KK153402/NESTang-LCD-Primer25K/src/nestang_top.sv

//
// NESTang top level
// nand2mario
//

// `timescale 1ns / 100ps

import configPackage::*;

module nestang_top (
    input sys_clk,

    // Button S1 and pin 48 are both resets
    input s1,
    input reset2,

    // UART
    input UART_RXD,
    output UART_TXD,

    // LEDs
    output [1:0] led,

    // SDRAM - Tang SDRAM pmod 1.2 for primer 25k, on-chip 32-bit 8MB SDRAM for nano 20k
    output O_sdram_clk,
    output O_sdram_cke,
    output O_sdram_cs_n,            // chip select
    output O_sdram_cas_n,           // columns address select
    output O_sdram_ras_n,           // row address select
    output O_sdram_wen_n,           // write enable
    inout [SDRAM_DATA_WIDTH-1:0] IO_sdram_dq,      // bidirectional data bus
    output [SDRAM_ROW_WIDTH-1:0] O_sdram_addr,     // multiplexed address bus
    output [1:0] O_sdram_ba,        // two banks
    output [SDRAM_DATA_WIDTH/8-1:0] O_sdram_dqm,    

    // MicroSD
    output sd_clk,
    inout  sd_cmd,      // MOSI
    input  sd_dat0,     // MISO
    output sd_dat1,     // 1
    output sd_dat2,     // 1
    output sd_dat3,     // 1

    // SPI flash
    output flash_spi_cs_n,          // chip select
    input flash_spi_miso,           // master in slave out
    output flash_spi_mosi,          // mster out slave in
    output flash_spi_clk,           // spi clock
    output flash_spi_wp_n,          // write protect
    output flash_spi_hold_n,        // hold operations

`ifdef CONTROLLER_SNES
    // snes controllers
    output joy1_strb,
    output joy1_clk,
    input joy1_data,
    output joy2_strb,
    output joy2_clk,
    input joy2_data,
`endif

`ifdef CONTROLLER_DS2
    // dualshock controllers
    output ds_clk,
    input ds_miso,
    output ds_mosi,
    output ds_cs,
    // 2P (ds_clk2/ds_miso2/ds_mosi2/ds_cs2) は LCD 制御に転用したため削除 [LCD]
`endif

    // USB
//     inout usbdm,
//     inout usbdp,
// `ifndef PRIMER
//     inout usbdm2,
//     inout usbdp2,
// `endif

    // HDMI TX -> ILI9341 8080 8bit LCD [LCD]
    output       lcd_rst_n,
    output       lcd_cs_n,
    output       lcd_rs,
    output       lcd_wr_n,
    output [7:0] lcd_d
    // lcd_rd_n は FPGA から出さない (LCD 側で 3.3 V に固定)
);

// Core settings
wire arm_reset = 0;
wire [1:0] system_type = 2'b0;
wire pal_video = 0;
wire [1:0] scanlines = 2'b0;
wire joy_swap = 0;
wire mirroring_osd = 0;
wire overscan_osd = 0;
wire famicon_kbd = 0;
wire [3:0] palette_osd = 0;
wire [2:0] diskside_osd = 0;
wire blend = 0;
wire bk_save = 0;

// NES signals
reg reset_nes = 1;
reg clkref;
wire [5:0] color;
wire [15:0] sample;
wire [8:0] scanline;
wire [8:0] cycle;
wire [2:0] joypad_out;
wire joypad_strobe = joypad_out[0];
wire [1:0] joypad_clock;
wire [4:0] joypad1_data, joypad2_data;

wire sdram_busy;
wire [21:0] memory_addr_cpu, memory_addr_ppu;
wire memory_read_cpu, memory_read_ppu;
wire memory_write_cpu, memory_write_ppu;
wire [7:0] memory_din_cpu, memory_din_ppu;
wire [7:0] memory_dout_cpu, memory_dout_ppu;

reg [7:0] joypad_bits, joypad_bits2;
reg [1:0] last_joypad_clock;
wire [31:0] dbgadr;
wire [1:0] dbgctr;

wire [1:0] nes_ce;

wire loading;                 // from iosys or game_data
wire [7:0] loader_do;
wire loader_do_valid;

// iosys softcore
wire        rv_valid;
reg         rv_ready;
wire [22:0] rv_addr;
wire [31:0] rv_wdata;
wire [3:0]  rv_wstrb;
reg  [15:0] rv_dout0;
wire [31:0] rv_rdata = {rv_dout, rv_dout0};
reg         rv_valid_r;
reg         rv_word;           // which word
reg         rv_req;
wire        rv_req_ack;
wire [15:0] rv_dout;
reg [1:0]   rv_ds;
reg         rv_new_req;

// Controller
wire [7:0] joy_rx[0:1], joy_rx2[0:1];     // 6 RX bytes for all button/axis state
wire [7:0] usb_btn, usb_btn2;
wire usb_btn_x, usb_btn_y, usb_btn_x2, usb_btn_y2;
wire usb_conerr, usb_conerr2;
wire auto_a, auto_b, auto_a2, auto_b2;

// OR together when both SNES and DS2 controllers are connected (right now only nano20k supports both simultaneously)
wor [11:0] joy1_btns, joy2_btns;    // SNES layout (R L X A RT LT DN UP START SELECT Y B)
                                    // Lower 8 bits are NES buttons

// NES gamepad
wire [7:0]NES_gamepad_button_state;
wire NES_gamepad_data_available;
wire [7:0]NES_gamepad_button_state2;
wire NES_gamepad_data_available2;

// Loader
wire [21:0] loader_addr;
wire [7:0] loader_write_data;
reg loading_r;
always @(posedge clk) loading_r <= loading;
wire loader_reset = loading & ~loading_r;
wire loader_write;
wire [63:0] loader_flags;
reg  [63:0] mapper_flags;
wire loader_done, loader_fail;
wire loader_busy, loaded;
wire type_nes = 1'b1;  // (menu_index == 0) || (menu_index == {2'd0, 6'h1});
wire type_bios = 1'b0; // (menu_index == 2);
wire is_bios = 0;      //type_bios;
wire type_fds = 1'b0;  // (menu_index == {2'd1, 6'h1});
wire type_nsf = 1'b0;  // (menu_index == {2'd2, 6'h1});

wire int_audio;         // for VCR6
wire ext_audio;

///////////////////////////
// Clocks
///////////////////////////

wire clk;       // 21.477Mhz main clock
wire fclk;      // 3x clk SDRAM clock
wire hclk;      // 720p pixel clock: 74.25 Mhz
wire hclk5;     // 5x pixel clock: 371.25 Mhz
wire clk27;     // 27Mhz to generate hclk/hclk5
wire clk_usb;   // 12Mhz USB clock

reg sys_resetn = 0;
reg [7:0] reset_cnt = 255;      // reset for 255 cycles before start everything
always @(posedge clk) begin
    reset_cnt <= reset_cnt == 0 ? 0 : reset_cnt - 1;
    if (reset_cnt == 0)
//    if (reset_cnt == 0 && s1)     // for nano
        sys_resetn <= ~(joy1_btns[5] && joy1_btns[2]);    // 8BitDo Home button = Select + Down
end

`ifndef VERILATOR

`ifdef PRIMER
// sysclk 50Mhz
gowin_pll_27 pll_27 (.clkin(sys_clk), .clkout0(clk27));      // Primer25K: PLL to generate 27Mhz from 50Mhz
gowin_pll_nes pll_nes (.clkin(sys_clk), .clkout0(clk), .clkout1(fclk), .clkout2(O_sdram_clk));
`else
// sys_clk 27Mhz
assign clk27 = sys_clk;       // Nano20K: native 27Mhz system clock
gowin_pll_nes pll_nes(.clkin(sys_clk), .clkoutd3(clk), .clkout(fclk), .clkoutp(O_sdram_clk));
`endif  // PRIMER

gowin_pll_hdmi pll_hdmi (
    .clkin(clk27),
    .clkout(hclk5)
);

CLKDIV #(.DIV_MODE(5)) div5 (
    .CLKOUT(hclk),
    .HCLKIN(hclk5),
    .RESETN(sys_resetn),
    .CALIB(1'b0)
);

`else   // verilator

// dummy clocks for verilator
assign clk = sys_clk;
assign fclk = sys_clk;

`endif  // verilator

wire [31:0] status;


// Main NES machine
NES nes(
    .clk(clk), .reset_nes(reset_nes), .cold_reset(1'b0),
    .sys_type(system_type), .nes_div(nes_ce),
    .mapper_flags(mapper_flags),
    .sample(sample), .color(color),
    .joypad_out(joypad_out), .joypad_clock(joypad_clock), 
    .joypad1_data(joypad1_data), .joypad2_data(joypad2_data),

    .fds_busy(), .fds_eject(), .diskside_req(), .diskside(),        // disk system
    .audio_channels(5'b11111),  // enable all channels
    
    .cpumem_addr(memory_addr_cpu),
    .cpumem_read(memory_read_cpu),
    .cpumem_din(memory_din_cpu),
    .cpumem_write(memory_write_cpu),
    .cpumem_dout(memory_dout_cpu),
    .ppumem_addr(memory_addr_ppu),
    .ppumem_read(memory_read_ppu),
    .ppumem_write(memory_write_ppu),
    .ppumem_din(memory_din_ppu),
    .ppumem_dout(memory_dout_ppu),

    .bram_addr(), .bram_din(), .bram_dout(), .bram_write(), .bram_override(),

    .cycle(cycle), .scanline(scanline),
    .int_audio(int_audio),    // VRC6
    .ext_audio(ext_audio),

    .apu_ce(), .gg(), .gg_code(), .gg_avail(), .gg_reset(), .emphasis(), .save_written()
);

// loader_write -> clock when data available
reg loader_write_mem;
reg [7:0] loader_write_data_mem;
reg [21:0] loader_addr_mem;
reg loader_write_r;

always @(posedge clk) begin
    loader_write_mem <= 0;
    loader_write_r <= loader_write;

    loader_write_mem <= loader_write || loader_write_r;   // width 2
	if (loader_write) begin
		loader_addr_mem <= loader_addr;
		loader_write_data_mem <= loader_write_data;
	end

    if (loader_done)
        mapper_flags <= loader_flags;
end

// From sdram_nes.v or sdram_sim.v
sdram_nes sdram (
    .clk(fclk), .clkref(clkref), .resetn(sys_resetn), .busy(sdram_busy),

    .SDRAM_DQ(IO_sdram_dq), .SDRAM_A(O_sdram_addr), .SDRAM_BA(O_sdram_ba), 
    .SDRAM_nCS(O_sdram_cs_n), .SDRAM_nWE(O_sdram_wen_n), .SDRAM_nRAS(O_sdram_ras_n), 
    .SDRAM_nCAS(O_sdram_cas_n), .SDRAM_CKE(O_sdram_cke), .SDRAM_DQM(O_sdram_dqm), 

    // PPU
    .addrA(memory_addr_ppu), .weA(memory_write_ppu), .dinA(memory_dout_ppu),
    .oeA(memory_read_ppu), .doutA(memory_din_ppu),

    // CPU
    .addrB(loading ? loader_addr_mem : memory_addr_cpu), .weB(loader_write_mem || memory_write_cpu),
    .dinB(loading ? loader_write_data_mem : memory_dout_cpu),
    .oeB(~loading & memory_read_cpu), .doutB(memory_din_cpu),

    // IOSys risc-v softcore
    .rv_addr({rv_addr[20:2], rv_word}), .rv_din(rv_word ? rv_wdata[31:16] : rv_wdata[15:0]), 
    .rv_ds(rv_ds), .rv_dout(rv_dout), .rv_req(rv_req), .rv_req_ack(rv_req_ack), .rv_we(rv_wstrb != 0)
);

// ROM parser
GameLoader loader(
    .clk(clk), .reset(~sys_resetn | loader_reset), .downloading(loading), 
    .filetype({4'b0000, type_nsf, type_fds, type_nes, type_bios}),
    .is_bios(is_bios), .invert_mirroring(1'b0),
    .indata(loader_do), .indata_clk(loader_do_valid),

    .mem_addr(loader_addr), .mem_data(loader_write_data), .mem_write(loader_write),
    .bios_download(),
    .mapper_flags(loader_flags), .busy(loader_busy), .done(loader_done),
    .error(loader_fail), .rom_loaded()
);

assign int_audio = 1;
assign ext_audio = (mapper_flags[7:0] == 19) | (mapper_flags[7:0] == 24) | (mapper_flags[7:0] == 26);

always @(posedge clk) begin
    clkref <= ~clkref;
    if (~loading && loading_r) begin
        reset_nes <= 0;
        clkref <= 1;
    end else if (loading && ~loading_r)
        reset_nes <= 1;
    if (~sys_resetn)
        reset_nes <= 1;
end

///////////////////////////
// Peripherals
///////////////////////////

`ifdef VERILATOR

// For verilator, the only peripheral is the compiled-in game data 
GameData game_data(
    .clk(clk), .reset(~sys_resetn), .downloading(loading), 
    .odata(loader_do), .odata_clk(loader_do_valid));

`else

// For physical board, there's HDMI, iosys, joypads, and USB
wire overlay;                   // iosys controls overlay
wire [10:0] overlay_x;
wire [9:0]  overlay_y;
wire [15:0] overlay_color;      // BGR5

// HDMI output -> LCD に置き換え [LCD]
assign overlay_x = 11'd0;   // nes2hdmi が駆動していた iosys(textdisp) の入力を固定
assign overlay_y = 10'd0;
wire lcd_init_done;

nes2lcd u_lcd (
    .clk(clk), .resetn(sys_resetn),
    .color(color), .cycle(cycle), .scanline(scanline),
    .lcd_rst_n(lcd_rst_n), .lcd_cs_n(lcd_cs_n), .lcd_rs(lcd_rs),
    .lcd_wr_n(lcd_wr_n), .lcd_rd_n(), .lcd_d(lcd_d),
    .init_done(lcd_init_done), .frame_start()
);

/*
nes2hdmi u_hdmi (     // purple: RGB=440064 (010001000_00000000_01100100), BGR5=01100_00000_01000
    .clk(clk), .resetn(sys_resetn),
    .color(color), .cycle(cycle), 
    .scanline(scanline), .sample(sample >> 1),
    .overlay(overlay), .overlay_x(overlay_x), .overlay_y(overlay_y),
    .overlay_color(overlay_color),
    .clk_pixel(hclk), .clk_5x_pixel(hclk5),
    .tmds_clk_n(tmds_clk_n), .tmds_clk_p(tmds_clk_p),
    .tmds_d_n(tmds_d_n), .tmds_d_p(tmds_d_p)
);
*/

// IOSys for menu, rom loading...
localparam RV_IDLE_REQ0 = 3'd0;
localparam RV_WAIT0_REQ1 = 3'd1;
localparam RV_DATA0 = 3'd2;
localparam RV_WAIT1 = 3'd3;
localparam RV_DATA1 = 3'd4;
reg [2:0]   rvst;

always @(posedge clk) begin            // RV
    if (~sys_resetn) begin
        rvst <= RV_IDLE_REQ0;
        rv_ready <= 0;
    end else begin
        reg write = rv_wstrb != 0;
        reg rv_new_req_t = rv_valid & ~rv_valid_r;
        if (rv_new_req_t) rv_new_req <= 1;

        rv_ready <= 0;
        rv_valid_r <= rv_valid;

        case (rvst)
        RV_IDLE_REQ0: if (rv_new_req || rv_new_req_t) begin
            rv_new_req <= 0;
            rv_req <= ~rv_req;
            if (write && rv_wstrb[1:0] == 2'b0) begin
                // shortcut for only writing the upper word
                rv_word <= 1;
                rv_ds <= rv_wstrb[3:2];
                rvst <= RV_WAIT1;
            end else begin
                rv_word <= 0;
                if (write)
                    rv_ds <= rv_wstrb[1:0];
                else
                    rv_ds <= 2'b11;
                rvst <= RV_WAIT0_REQ1;
            end
        end

        RV_WAIT0_REQ1: begin
            if (rv_req == rv_req_ack) begin
                rv_req <= ~rv_req;      // request 1
                rv_word <= 1;
                if (write) begin
                    rvst <= RV_WAIT1;
                    if (rv_wstrb[3:2] == 2'b0) begin
                        // shortcut for only writing the lower word
                        rv_req <= rv_req;
                        rv_ready <= 1;
                        rvst <= RV_IDLE_REQ0;
                    end
                    rv_ds <= rv_wstrb[3:2];
                end else begin
                    rv_ds <= 2'b11;
                    rvst <= RV_DATA0;
                end
            end
        end

        RV_DATA0: begin
            rv_dout0 <= rv_dout;
            rvst <= RV_WAIT1;
        end
            
        RV_WAIT1: 
            if (rv_req == rv_req_ack) begin
                if (write)  begin
                    rv_ready <= 1;
                    rvst <= RV_IDLE_REQ0;
                end else
                    rvst <= RV_DATA1;
            end

        RV_DATA1: begin
            rv_ready <= 1;
            rvst <= RV_IDLE_REQ0;
        end

        default:;
        endcase
    end
end

iosys #(.COLOR_LOGO(15'b01100_00000_01000), .CORE_ID(1) )     // purple nestang logo
    iosys (
    .clk(clk), .hclk(hclk), .resetn(sys_resetn),

    .overlay(overlay), .overlay_x(overlay_x), .overlay_y(overlay_y),
    .overlay_color(overlay_color),
    .joy1(joy1_btns), .joy2(joy2_btns),

    .rom_loading(loading), .rom_do(loader_do), .rom_do_valid(loader_do_valid), 
    .ram_busy(sdram_busy),

    .rv_valid(rv_valid), .rv_ready(rv_ready), .rv_addr(rv_addr),
    .rv_wdata(rv_wdata), .rv_wstrb(rv_wstrb), .rv_rdata(rv_rdata),

    .flash_spi_cs_n(flash_spi_cs_n), .flash_spi_miso(flash_spi_miso),
    .flash_spi_mosi(flash_spi_mosi), .flash_spi_clk(flash_spi_clk),
    .flash_spi_wp_n(flash_spi_wp_n), .flash_spi_hold_n(flash_spi_hold_n),

    .uart_tx(UART_TXD), .uart_rx(UART_RXD),

    .sd_clk(sd_clk), .sd_cmd(sd_cmd), .sd_dat0(sd_dat0), .sd_dat1(sd_dat1),
    .sd_dat2(sd_dat2), .sd_dat3(sd_dat3)
);

// Controller input
`ifdef CONTROLLER_SNES
controller_snes joy1_snes (
    .clk(clk), .resetn(sys_resetn), .buttons(joy1_btns),
    .joy_strb(joy1_strb), .joy_clk(joy1_clk), .joy_data(joy1_data)
);
controller_snes joy2_snes (
    .clk(clk), .resetn(sys_resetn), .buttons(joy2_btns),
    .joy_strb(joy2_strb), .joy_clk(joy2_clk), .joy_data(joy2_data)
);
`endif

`ifdef CONTROLLER_DS2
controller_ds2 joy1_ds2 (
    .clk(clk), .snes_buttons(joy1_btns),
    .ds_clk(ds_clk), .ds_miso(ds_miso), .ds_mosi(ds_mosi), .ds_cs(ds_cs) 
);
// 2P は削除 [LCD]。wor にドライバが無いと不定になるので 0 (未押下) に固定
assign joy2_btns = 12'd0;
`endif

// Autofire for NES A (right) and B (left) buttons
Autofire af_a (.clk(clk), .resetn(sys_resetn), .btn(joy1_btns[8]), .out(auto_a));
Autofire af_b (.clk(clk), .resetn(sys_resetn), .btn(joy1_btns[9]), .out(auto_b));
Autofire af_a2 (.clk(clk), .resetn(sys_resetn), .btn(joy2_btns[8]), .out(auto_a2));
Autofire af_b2 (.clk(clk), .resetn(sys_resetn), .btn(joy2_btns[9]), .out(auto_b2));

// Joypad handling
always @(posedge clk) begin
    if (joypad_strobe) begin
        joypad_bits <= {joy1_btns[7:2], joy1_btns[1] | auto_b, joy1_btns[0] | auto_a};;
        joypad_bits2 <= {joy2_btns[7:2], joy2_btns[1] | auto_b2, joy2_btns[0] | auto_a2};
    end
    if (!joypad_clock[0] && last_joypad_clock[0])
        joypad_bits <= {1'b1, joypad_bits[7:1]};
    if (!joypad_clock[1] && last_joypad_clock[1])
        joypad_bits2 <= {1'b1, joypad_bits2[7:1]};
    last_joypad_clock <= joypad_clock;
end
assign joypad1_data[0] = joypad_bits[0];
assign joypad2_data[0] = joypad_bits2[0];

//   usb_btn:      (R L D U START SELECT B A)
// wire [1:0] usb_type, usb_type2;
// wire usb_report, usb_report2;
// usb_hid_host usb_controller (
//     .usbclk(clk_usb), .usbrst_n(sys_resetn),
//     .usb_dm(usbdm), .usb_dp(usbdp),	.typ(usb_type), .report(usb_report), 
//     .game_l(usb_btn[6]), .game_r(usb_btn[7]), .game_u(usb_btn[4]), .game_d(usb_btn[5]), 
//     .game_a(usb_btn[0]), .game_b(usb_btn[1]), .game_x(usb_btn_x), .game_y(usb_btn_y), 
//     .game_sel(usb_btn[2]), .game_sta(usb_btn[3]),
//     // ignore keyboard and mouse input
//     .key_modifiers(), .key1(), .key2(), .key3(), .key4(),
//     .mouse_btn(), .mouse_dx(), .mouse_dy(),
//     .dbg_hid_report()
// );

// `ifndef PRIMER
// usb_hid_host usb_controller2 (
//     .usbclk(clk_usb), .usbrst_n(sys_resetn),
//     .usb_dm(usbdm2), .usb_dp(usbdp2),	.typ(usb_type2), .report(usb_report2), 
//     .game_l(usb_btn2[6]), .game_r(usb_btn2[7]), .game_u(usb_btn2[4]), .game_d(usb_btn2[5]), 
//     .game_a(usb_btn2[0]), .game_b(usb_btn2[1]), .game_x(usb_btn_x2), .game_y(usb_btn_y2), 
//     .game_sel(usb_btn2[2]), .game_sta(usb_btn2[3]),
//     // ignore keyboard and mouse input
//     .key_modifiers(), .key1(), .key2(), .key3(), .key4(),
//     .mouse_btn(), .mouse_dx(), .mouse_dy(),
//     .dbg_hid_report()
// );
// `endif

`endif

//assign led = ~{~UART_RXD, loader_done};
//assign led = ~{~UART_RXD, usb_conerr, loader_done};
// [LCD] READY(led[1]) = LCD 初期化完了, DONE(led[0]) = パッド 3 (NES A)
assign led = {lcd_init_done, joy1_btns[0]};

reg [23:0] led_cnt;
always @(posedge clk) led_cnt <= led_cnt + 1;
//assign led = {led_cnt[23], led_cnt[22]};

endmodule
